Darshumar/ioniq6-display/esp32/enclosure/README.md

# Gehäuse

Gehäuse, Akkuwanne und Ständer für das Waveshare ESP32-S3-Touch-LCD-4.3 liegen in [ws43/](ws43/README.md).

*English:* enclosure, battery tray and stand for the Waveshare ESP32-S3-Touch-LCD-4.3 are in [ws43/](ws43/README.en.md).
