Darshumar/ioniq6-display/docs/esp32_akku_laden_heizen.png

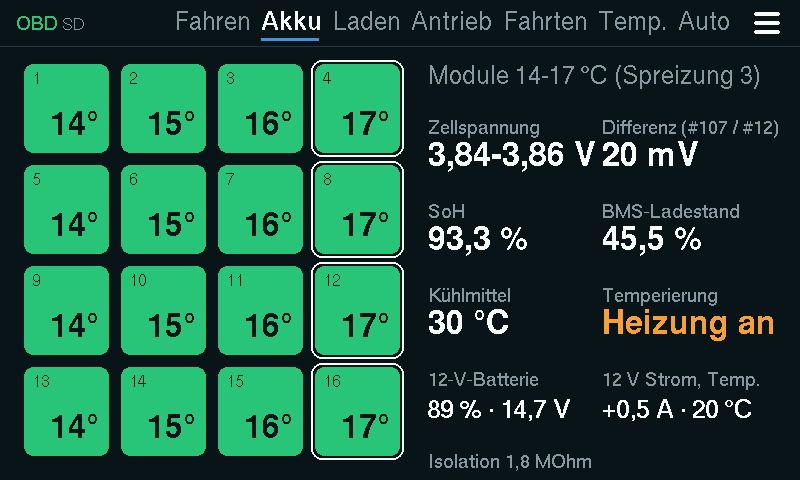
docs/esp32_akku_laden_heizen.png
