Darshumar/ioniq6-display/docs/esp32_auto_licht.png

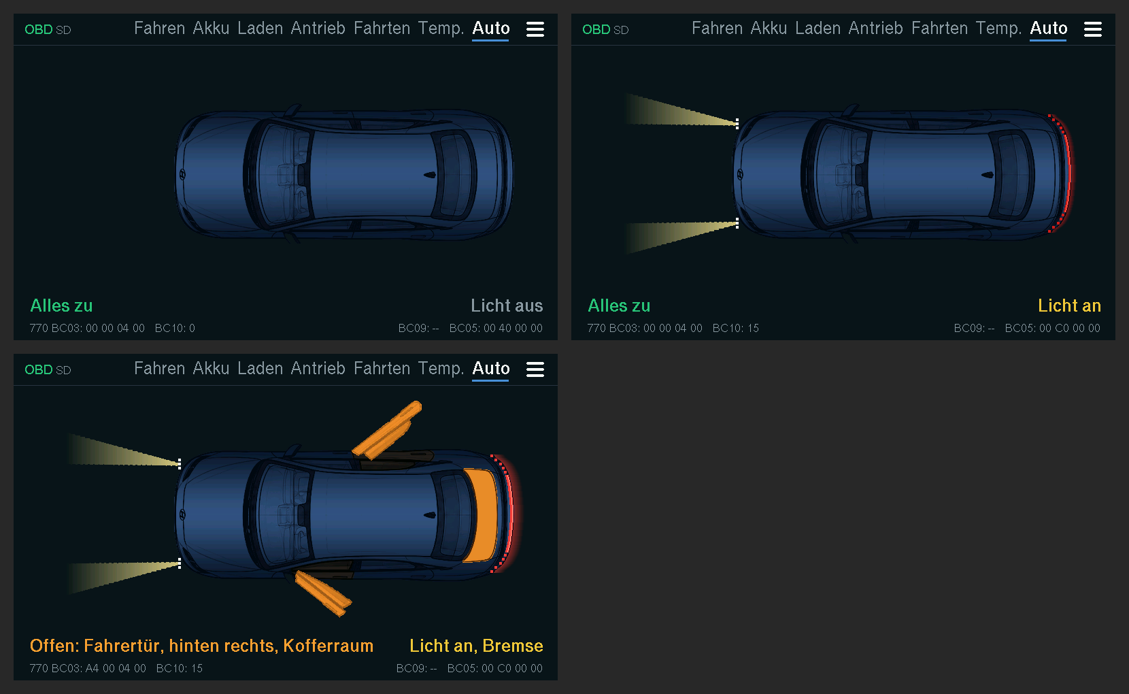
docs/esp32_auto_licht.png
