Darshumar/ioniq6-display/esp32/enclosure/ws43/ablage_display_seite.png

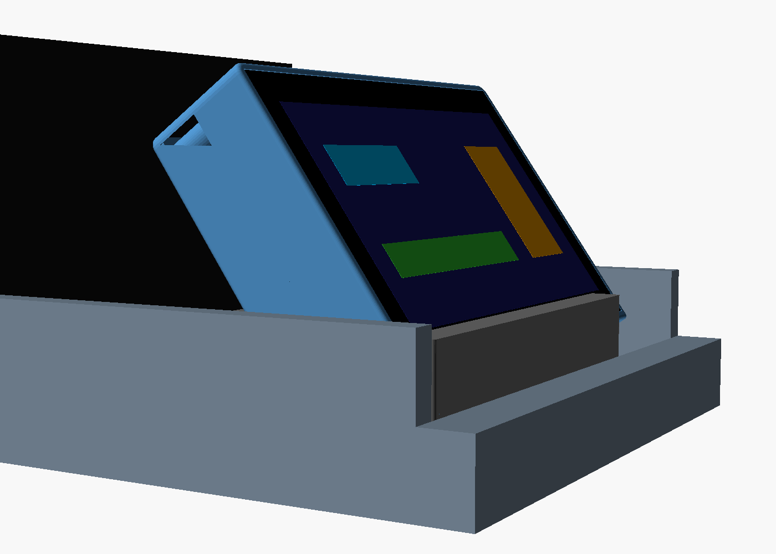
esp32/enclosure/ws43/ablage_display_seite.png
