Darshumar/ioniq6-display/esp32/enclosure/ws43/preview_staender.png

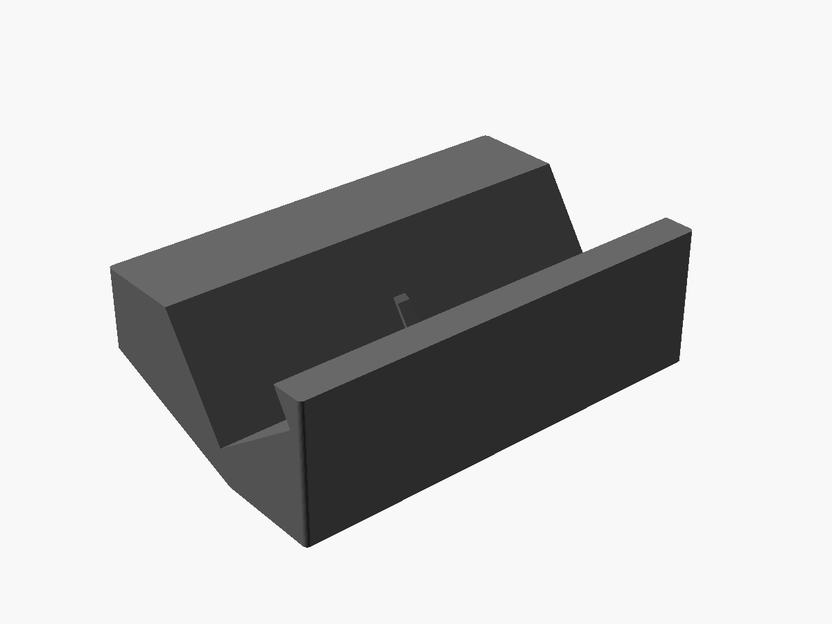
esp32/enclosure/ws43/preview_staender.png
