Darshumar/ioniq6-display/esp32/enclosure/ws43/vergleich_winkel.png

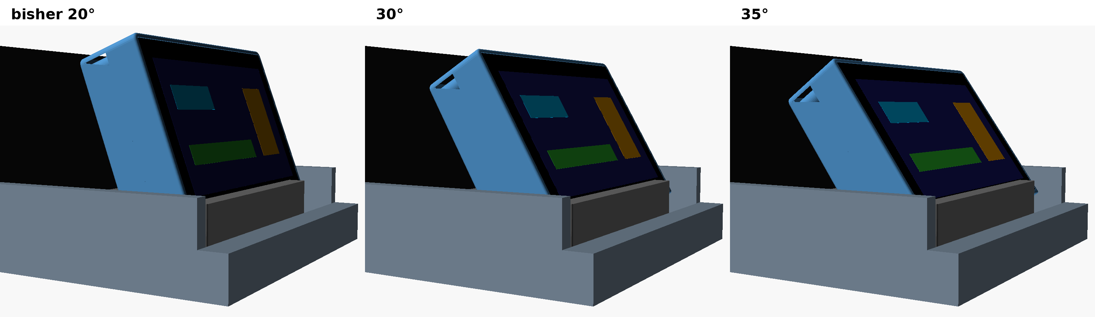
esp32/enclosure/ws43/vergleich_winkel.png
