Darshumar/ioniq6-display/esp32/enclosure/ws43/stl/ws43_staender_akku.stl

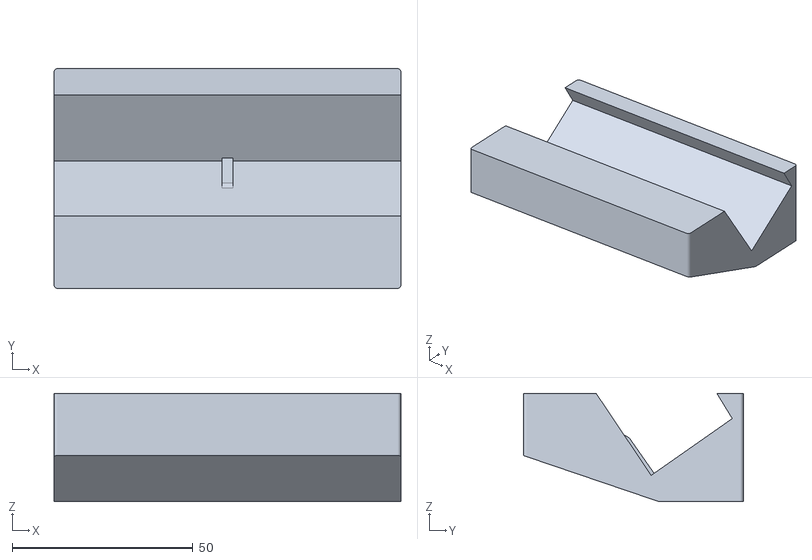
[picture p21: CAD file, 2026-10-31]
esp32/enclosure/ws43/stl/ws43_staender_akku.stl
96.0 x 60.8 x 30.0
