Darshumar/ioniq6-display/esp32/enclosure/ws43/stl/ws43_fluegel_mulde.stl

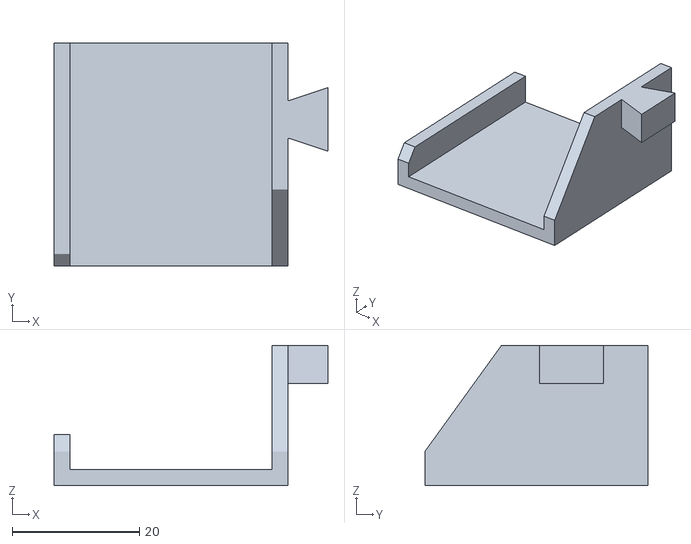
[picture p22: CAD file, 2026-10-31]
esp32/enclosure/ws43/stl/ws43_fluegel_mulde.stl
43.0 x 35.0 x 22.0
