Darshumar/ioniq6-display/esp32/enclosure/ws43/stl/ws43_tray_original.stl

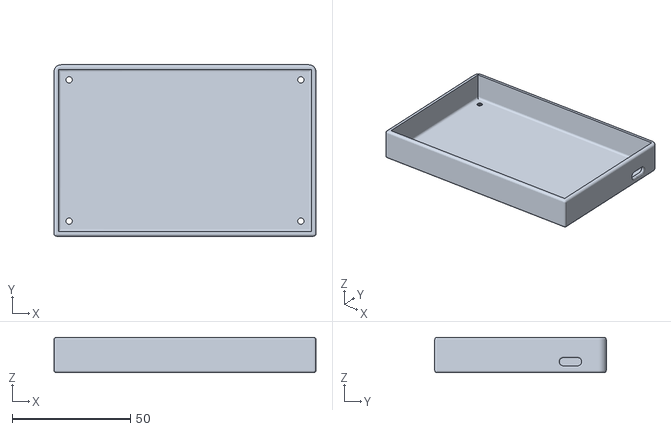
[picture p23: CAD file, 2026-10-31]
esp32/enclosure/ws43/stl/ws43_tray_original.stl
110.9 x 72.6 x 15.0
