Darshumar/ioniq6-display/esp32/enclosure/ws43/stl/ws43_tray_akku.stl

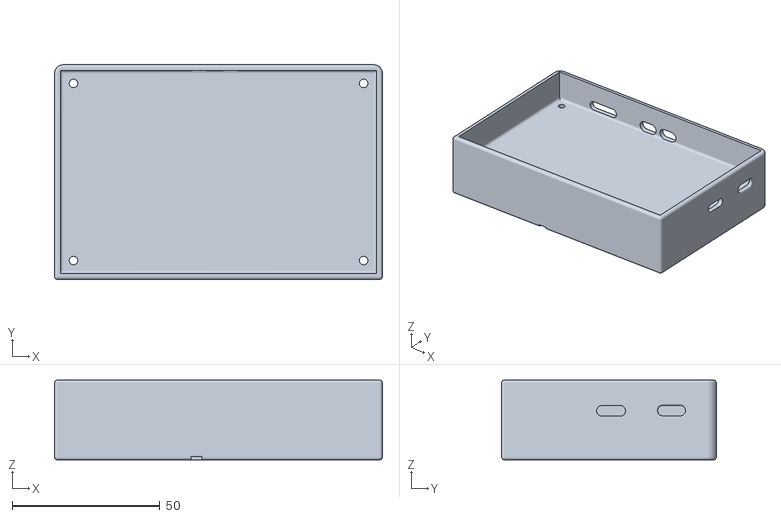
[picture p24: CAD file, 2026-10-31]
esp32/enclosure/ws43/stl/ws43_tray_akku.stl
110.9 x 72.6 x 27.0
