Darshumar/ioniq6-display/esp32/enclosure/ws43/stl/ws43_tastenkappen_kragen.stl

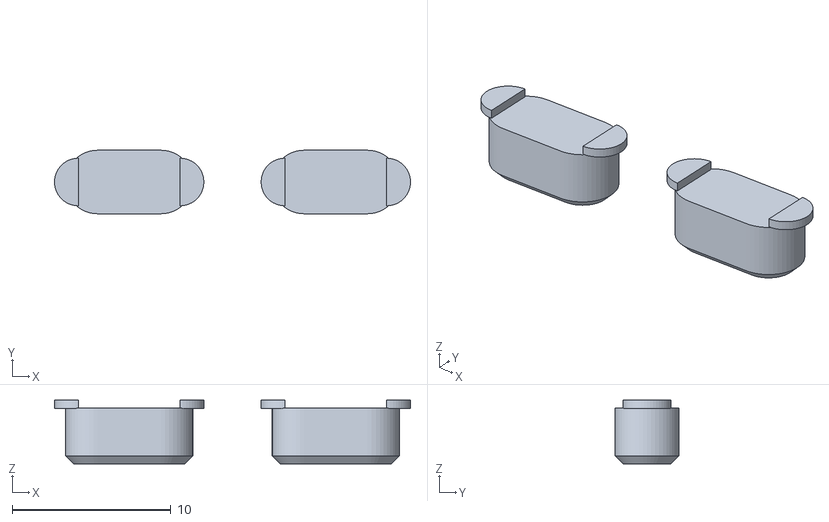
[picture p25: CAD file, 2026-10-31]
esp32/enclosure/ws43/stl/ws43_tastenkappen_kragen.stl
22.4 x 4.00 x 4.00
