Darshumar/ioniq6-display/(commit log)

2026-10-31 Ioniq 6 Anzeige, oeffentliche Ausgabe (FW 86): Firmware, Gehaeuse, Doku
    Logs bleiben auf der SD-Karte, kein Upload, keine Logs im Repo.
    Claude-Session: https://claude.ai/code/session_01EavKLyozRGKjHUY2zmAeZh
    [ablage_modell.scad, ws43_akkufach.scad, ws43_fluegel_mulde.stl, ws43_staender_akku.stl, ws43_tastenkappen_kragen.stl, ws43_tray_akku.stl, ws43_tray_original.stl]
2026-10-31 Englische Beschreibungen (README.en.md) fuer Uebersicht, Firmware und Gehaeuse
    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
2026-11-03 FW 87: Heizung beim DC-Laden erkennen, Saeulenleistung auf der Laden-Seite
    Claude-Session: https://claude.ai/code/session_01EavKM1qwZF41Whnmq8Q3WC
2026-11-04 FW 89: Werte schneller anzeigen
    Jeder Durchlauf fragt nur noch das BMS 220101 (Leistung, Strom, SoC,
    Drehzahl, daraus das Tempo). Alle anderen Abfragen haben einen eigenen
    Takt und kommen reihum (am laengsten ueberfaellige zuerst, 250 ms
    Budget je Durchlauf, aktive Seite schneller). Kopfzeile nur bei Wechsel,
    ATAT2 mit Rueckfall auf ATAT1, CSV weiter alle 2 s, Zeiten im diag-Log.
    Claude-Session: https://claude.ai/code/session_01EavKM3obUFwfv4uuvdqLnN
2026-11-05 FW 94: Licht-Fix (kein Dauer-Fernlicht), Tagfahrlicht
    Code aus Darshumar/Ioniq6_obd PR #45, oeffentliche Bins aus der CI.
    Claude-Session: https://claude.ai/code/session_01EavKM3oDQM5BJX82q7nwQb
    [decode.cpp, decode.h, demo.cpp, ui.cpp]
2026-11-06 FW 96: Licht an aus dem Lichtschalter-Byte (770 22BC05)
    Code aus Darshumar/Ioniq6_obd PR #46, oeffentliche Bins aus der CI.
    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
